EmmetGameDev/Nevolta-CD-Console/PCB/bom.csv

Designator | Footprint | Quantity | Value | LCSC Part #
C1 | 0603 | 1 | 22uF
C10, C3, C7, C8 | 0603 | 4 | 10uF
C11, C12, C13, C2, C4, C9 | 0603 | 6 | 100nF
C5 | CP_EIA-3216-18_Kemet-A | 1 | 10uF
C6 | CP_EIA-3216-18_Kemet-A | 1 | 22uF
D1 | 0603 | 1 | BLUE
D2 | 0603 | 1 | RED
J1 | 0603 | 1 | ~
J2 | USB_C_Receptacle_GCT_USB4105-xx-A_16P_TopMnt_Horizontal | 1 | USB_C_Receptacle_USB2.0_16P | C2765186
J3 | OLED128x32_1x04_P2.54mm_socket | 1 | Conn_Oled
J4 | ADA_Mini_Thumbstick | 1 | Thumbstick_L
J5 | ADA_Mini_Thumbstick | 1 | Thumbstick_R
J6 | JST_ZH_S2B-ZR-SM4A-TF_1x02-1MP_P1.50mm_Horizontal | 1 | Batt_Conn | C2845424
Q1 | SOT-23 IRLML6401 | 1 | PMOS | C382329
Q2 | SOT-23-6 | 1 | ~
R1, R7 | 0603 | 2 | 100R
R10, R8, R9 | 0603 | 3 | 1k
R11 | 0603 | 1 | 1.2k
R12, R13, R14, R15, R3, R5, R6 | 0603 | 7 | 100k
R16, R17 | 0603 | 2 | 5.1k
R2, R4 | 0603 | 2 | 10k
SW1 | ALPSALPINE SMT SPDT Right Angle Switch | 1 | SW_PWR
SW10 | SW_PUSH_8mm_H5mm_custom | 1 | NAV_X
SW11 | SW_PUSH_8mm_H5mm_custom | 1 | NAV_Y
SW12 | SW_PUSH_8mm_H5mm_custom | 1 | CTR_Back
SW13 | SW_PUSH_8mm_H5mm_custom | 1 | CTR_Start
SW14 | SW_PUSH_8mm_H5mm_custom | 1 | CTR_HOME
SW15 | SHOU HAN TS24CA | 1 | BMP_L
SW16 | TS-1224VW | 1 | TR_L
SW17 | SHOU HAN TS24CA | 1 | BMP_R
SW18 | TS-1224VW | 1 | TR_R
SW2 | SW_SPST_TS-1088-xR020 | 1 | BOOT
SW3 | SW_SPST_TS-1088-xR020 | 1 | EN
SW4 | SW_PUSH_8mm_H5mm_custom | 1 | Dpad_UP
SW5 | SW_PUSH_8mm_H5mm_custom | 1 | Dpad_DOWN
SW6 | SW_PUSH_8mm_H5mm_custom | 1 | Dpad_LEFT
SW7 | SW_PUSH_8mm_H5mm_custom | 1 | Dpad_RIGHT
SW8 | SW_PUSH_8mm_H5mm_custom | 1 | NAV_A
SW9 | SW_PUSH_8mm_H5mm_custom | 1 | NAV_B
TP1 | TestPoint_Pad_D2.0mm | 1 | AMS_3v3
TP2 | TestPoint_Pad_D2.0mm | 1 | MIC_3v3
TP3 | TestPoint_Pad_D2.0mm | 1 | 5V
TP4 | TestPoint_Pad_D2.0mm | 1 | GND
U1 | ESP32-S3-WROOM-1 | 1 | ESP32-S3-WROOM-1
U2 | SOT-223-3_TabPin2 | 1 | AMS1117-3.3
U3 | SOT-23-5 | 1 | MIC5219-3.3YM5
U4 | SOT-23-6 | 1 | DW01A
U5 | SOIC-8-1EP_3.9x4.9mm_P1.27mm_EP2.41x3.3mm_ThermalVias | 1 | TP4056-42-ESOP8
U6 | SOT-23-6 | 1 | USBLC6-2SC6 | C2827654
