EmmetGameDev/Nevolta-CD-Console/Printables/Controller_Faceplate.3mf

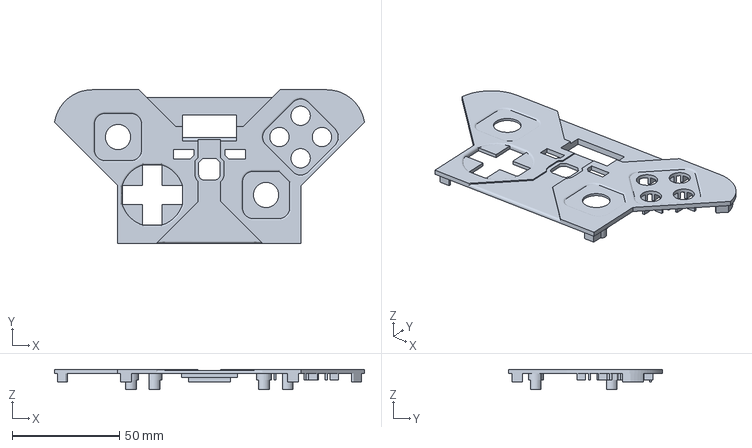
[picture p2: CAD file, 2026-10-15]
Printables/Controller_Faceplate.3mf
144.4 x 71.5 x 9.45 mm
