EmmetGameDev/Nevolta-CD-Console/Printables/Console_Bottom.3mf

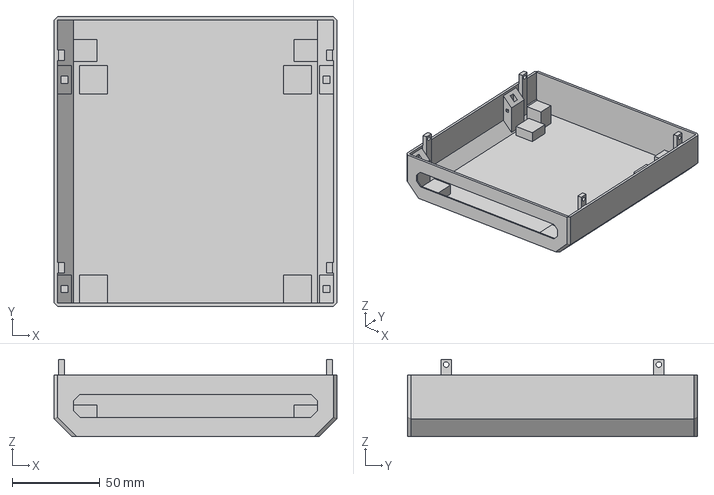
[picture p3: CAD file, 2026-10-15]
Printables/Console_Bottom.3mf
161.0 x 165.0 x 44.0 mm
