EmmetGameDev/Nevolta-CD-Console/Printables/Console_Crossbar.3mf

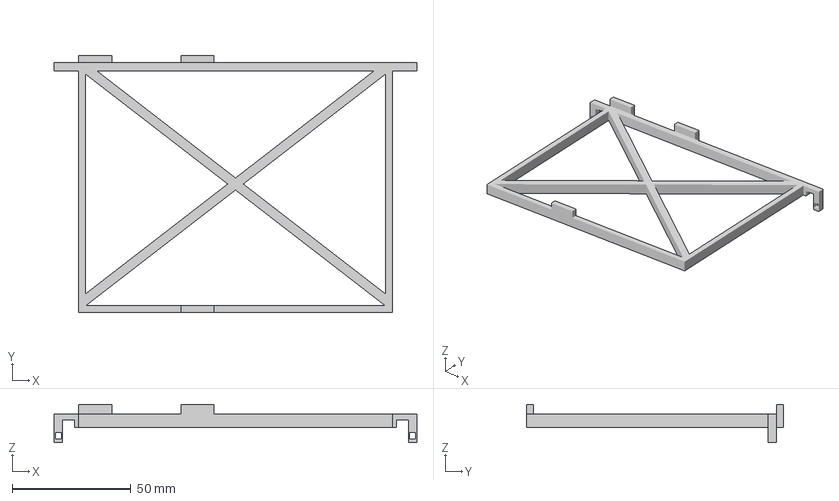
[picture p4: CAD file, 2026-10-15]
Printables/Console_Crossbar.3mf
152.6 x 108.0 x 16.0 mm
