EmmetGameDev/Nevolta-CD-Console/Printables/Controller_Triggers.3mf

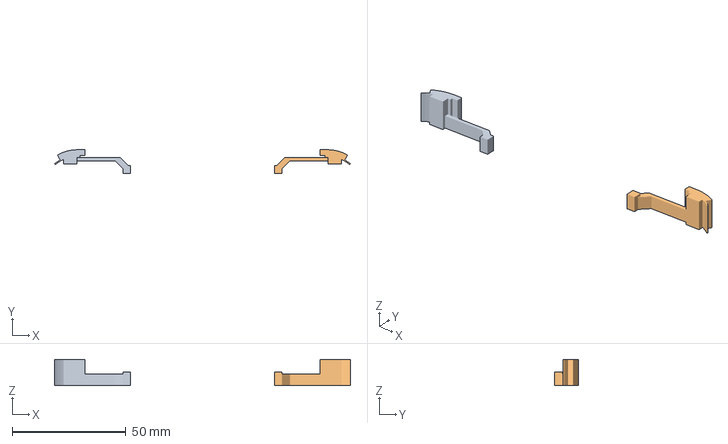
[picture p5: CAD file, 2026-10-15]
Printables/Controller_Triggers.3mf
129.9 x 10.4 x 11.5 mm
TriggerL
TriggerR
