EmmetGameDev/Nevolta-CD-Console/Printables/Controller_Bumpers.3mf

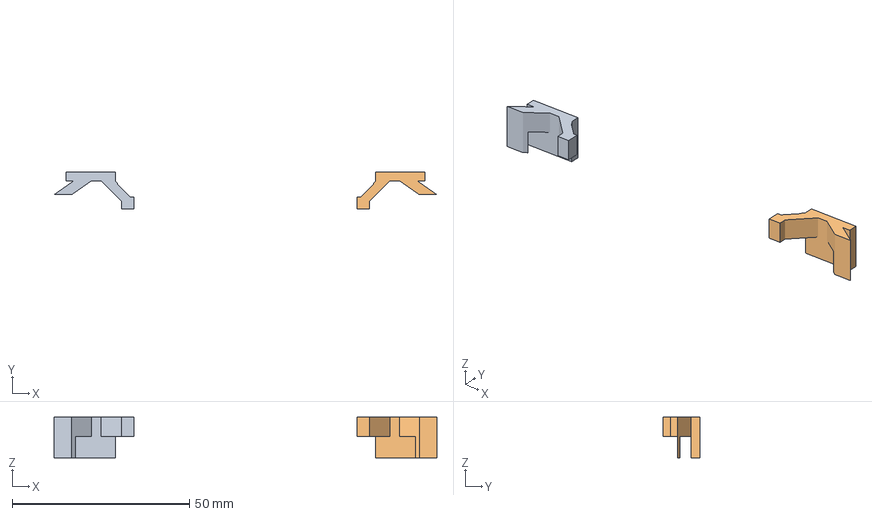
[picture p6: CAD file, 2026-10-15]
Printables/Controller_Bumpers.3mf
108.1 x 10.4 x 11.5 mm
BumperL
BumperR
