EmmetGameDev/Nevolta-CD-Console/Printables/Controller_Body.3mf

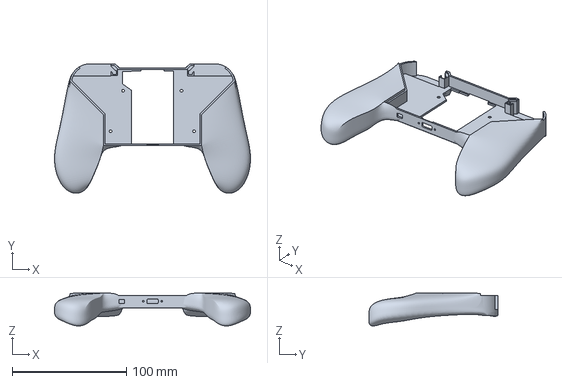
[picture p7: CAD file, 2026-10-15]
Printables/Controller_Body.3mf
171.3 x 113.1 x 28.7 mm
