EmmetGameDev/Nevolta-CD-Console/Printables/Controller_Batteryslot.3mf

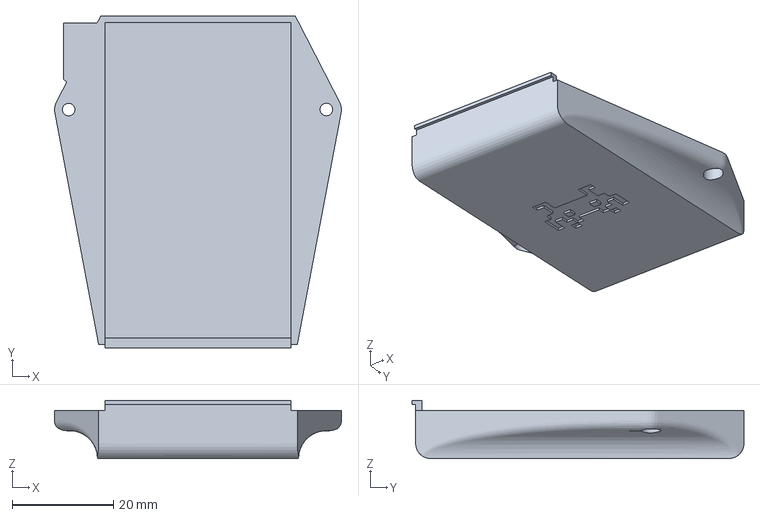
[picture p8: CAD file, 2026-10-15]
Printables/Controller_Batteryslot.3mf
56.8 x 65.7 x 11.5 mm
