EmmetGameDev/Nevolta-CD-Console/Printables/Controller_Buttons.3mf

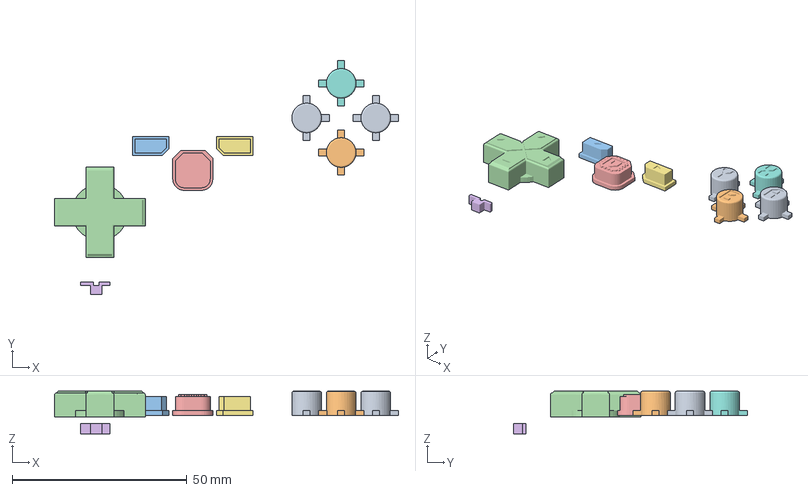
[picture p9: CAD file, 2026-10-15]
Printables/Controller_Buttons.3mf
98.5 x 66.9 x 12.2 mm
A
B
Back
Dpad
Home
PowerSwitch
Start
X
Y
