EmmetGameDev/Nevolta-CD-Console/Printables/Console_Top.3mf

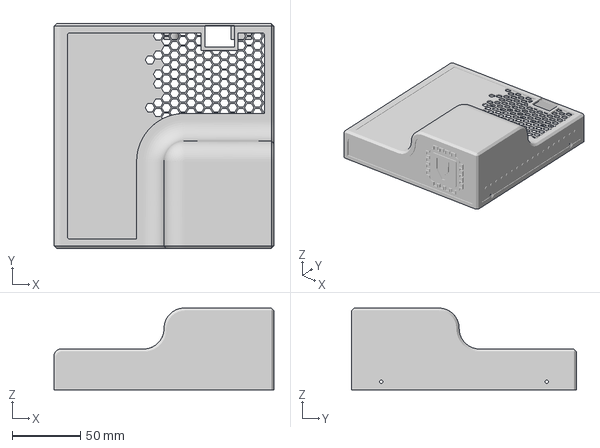
[picture p10: CAD file, 2026-10-15]
Printables/Console_Top.3mf
161.0 x 165.0 x 60.0 mm
