EmmetGameDev/Nevolta-CD-Console/(commit log)

2026-10-15 Repo init
    [Console_Bottom.3mf, Console_Crossbar.3mf, Console_Top.3mf, Controller_Batteryslot.3mf, Controller_Body.3mf, Controller_Bumpers.3mf, Controller_Buttons.3mf, Controller_Faceplate.3mf]
2026-10-24 Updated assembly and setup instructions.
